strickyak/cocoio-bufferio-kicad/cocoio-bufferio-4/cocoio-bufferio-4.png

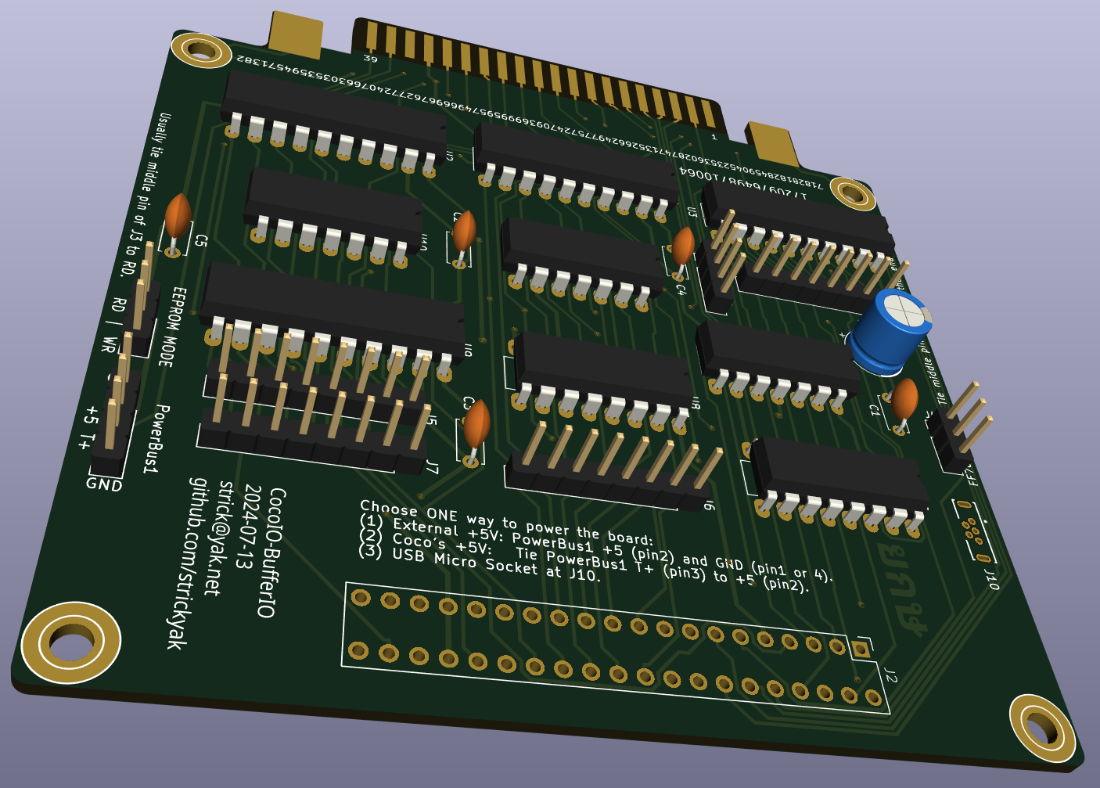
cocoio-bufferio-4/cocoio-bufferio-4.png
