strickyak/cocoio-bufferio-kicad/README.md

# cocoio-bufferio-kicad
for diagnostic use
