strickyak/cocoio-bufferio-kicad/cocoio-bufferio-4/cocoio-bufferio-4.kicad_pcb

## KiCad design cocoio-bufferio-4/cocoio-bufferio-4.kicad_pcb (2024-07-16)

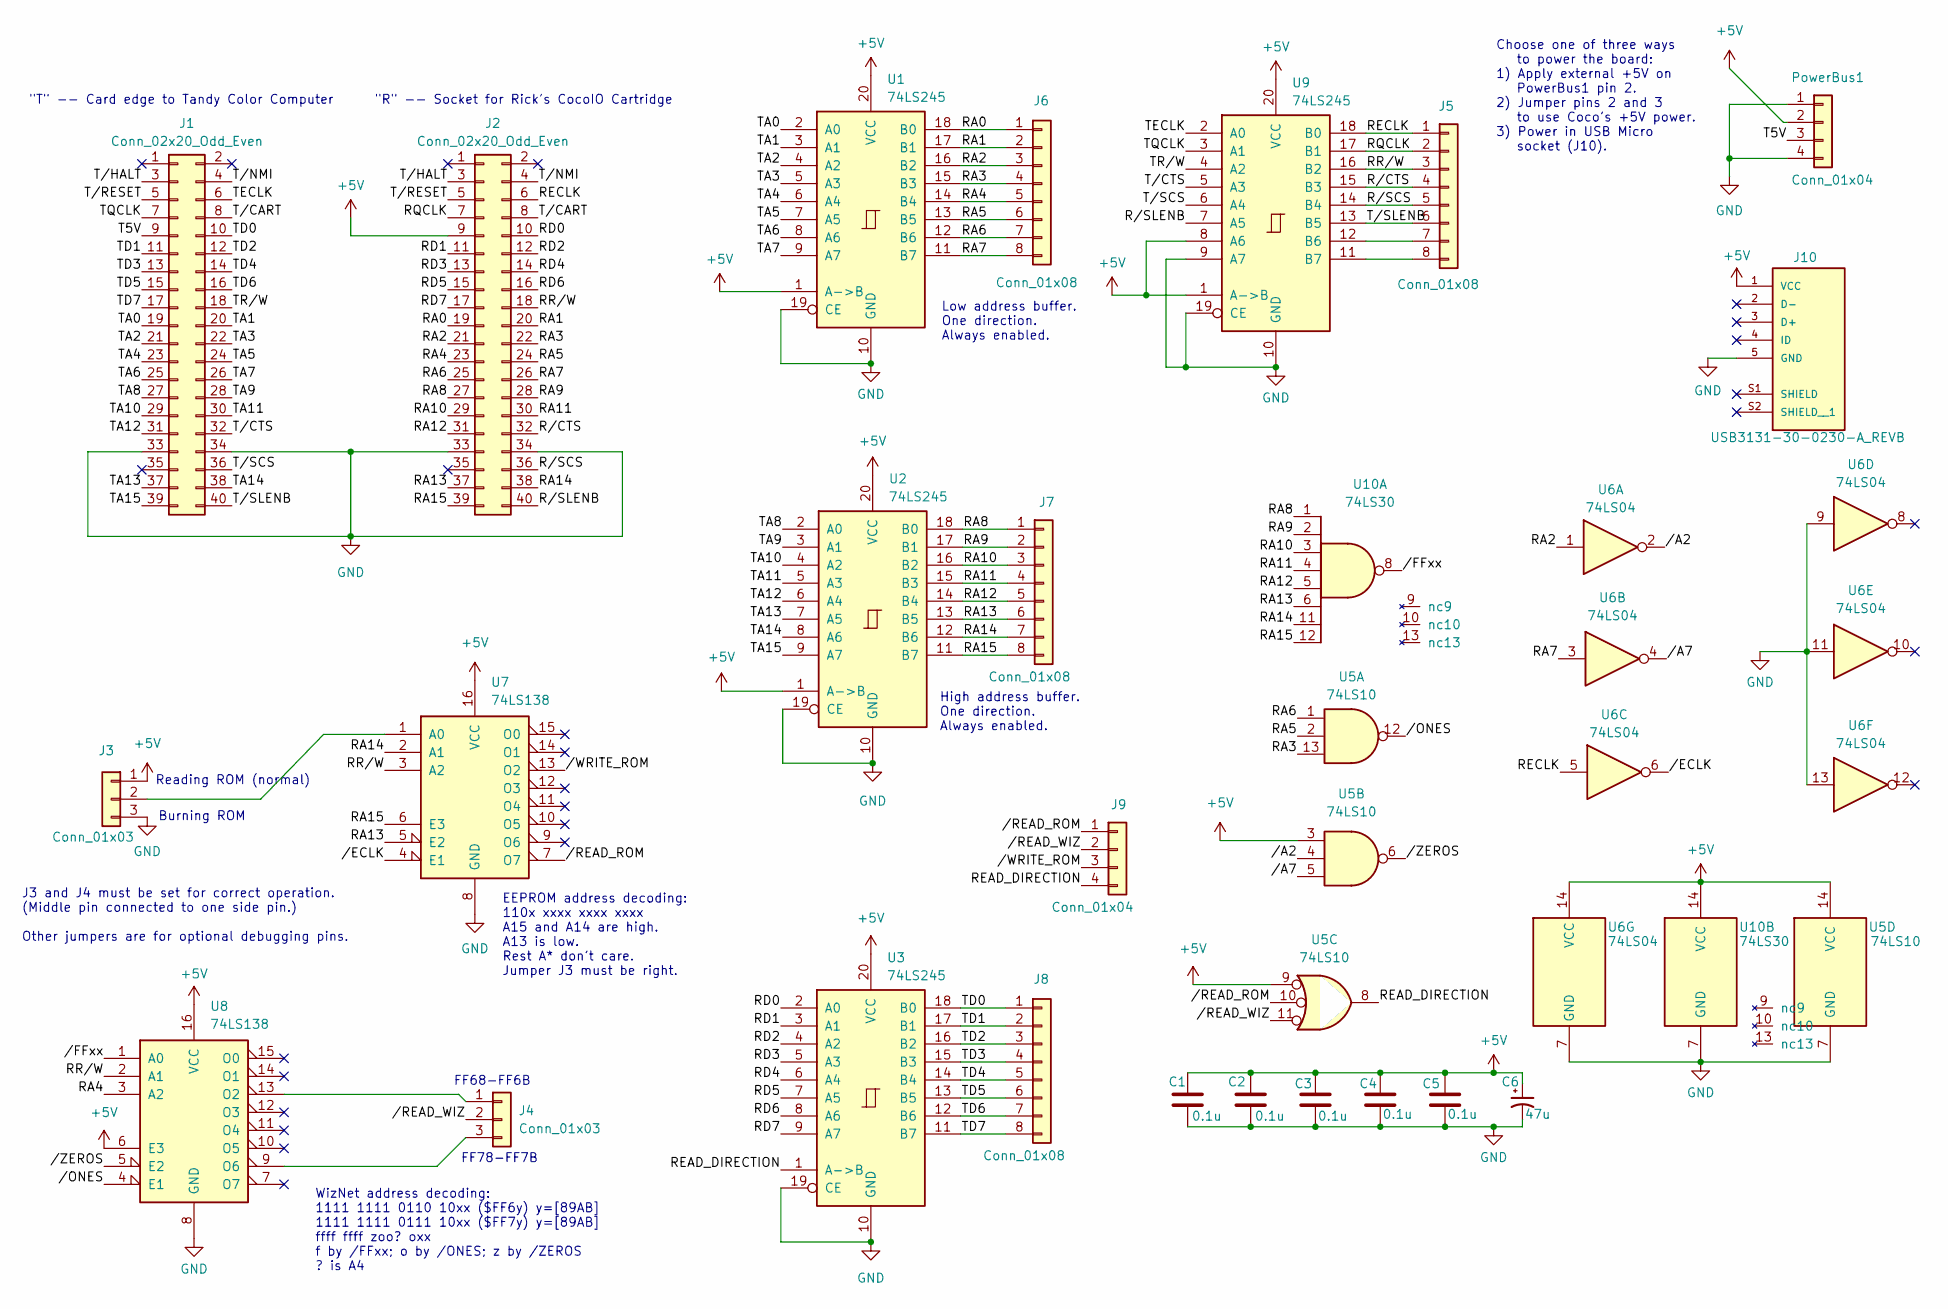
[picture p2: schematic cocoio-bufferio-4.kicad_sch, CocoIO-BufferIO]

Parts:
C1, C2, C3, C4, C5: 0.1u; C_Disc_D5.0mm_W2.5mm_P5.00mm
C6: 47u; CP_Radial_D7.5mm_P2.50mm
J1: Conn_02x20_Odd_Even; CocoCardEdge
J2: Conn_02x20_Odd_Even; Coco_Card_Female
J3, J4: Conn_01x03; PinHeader_1x03_P2.54mm_Vertical
J5, J6, J7, J8: Conn_01x08; PinHeader_1x08_P2.54mm_Vertical
J9: Conn_01x04; PinHeader_1x04_P2.54mm_Vertical
J10: USB3131-30-0230-A_REVB; GCT_USB3131-30-0230-A_REVB; PARTREV B4
PowerBus1: Conn_01x04; PinHeader_1x04_P2.54mm_Vertical
U1, U2, U3, U9: 74LS245; DIP-20_W7.62mm_LongPads
U5: 74LS10; DIP-14_W7.62mm_LongPads
U6: 74LS04; DIP-14_W7.62mm_LongPads
U7, U8: 74LS138; DIP-16_W7.62mm_LongPads
U10: 74LS30; DIP-14_W7.62mm_LongPads

Connections:
+5V: C1.1, C2.1, C3.1, C4.1, C5.1, C6.1, J2.9, J3.1, J10.1 (VCC), PowerBus1.2, U1.1 (A->B), U1.20 (VCC), U2.1 (A->B), U2.20 (VCC), U3.20 (VCC), U5.3, U5.9, U5.14 (VCC), U6.14 (VCC), U7.16 (VCC), U8.6 (E3), U8.16 (VCC), U9.1 (A->B), U9.8 (A6), U9.20 (VCC), U10.14 (VCC)
/RA0: J2.19, J6.1, U1.18 (B0)
/RA1: J2.20, J6.2, U1.17 (B1)
/RA2: J2.21, J6.3, U1.16 (B2), U6.1
/RA3: J2.22, J6.4, U1.15 (B3), U5.13
/RA4: J2.23, J6.5, U1.14 (B4), U8.3 (A2)
/RA5: J2.24, J6.6, U1.13 (B5), U5.2
/RA6: J2.25, J6.7, U1.12 (B6), U5.1
/RA7: J2.26, J6.8, U1.11 (B7), U6.3
/RA8: J2.27, J7.1, U2.18 (B0), U10.1
/RA9: J2.28, J7.2, U2.17 (B1), U10.2
/RA10: J2.29, J7.3, U2.16 (B2), U10.3
/RA11: J2.30, J7.4, U2.15 (B3), U10.4
/RA12: J2.31, J7.5, U2.14 (B4), U10.5
/RA13: J2.37, J7.6, U2.13 (B5), U7.5 (E2), U10.6
/RA14: J2.38, J7.7, U2.12 (B6), U7.2 (A1), U10.11
/RA15: J2.39, J7.8, U2.11 (B7), U7.6 (E3), U10.12
/RD0: J2.10, U3.2 (A0)
/RD1: J2.11, U3.3 (A1)
/RD2: J2.12, U3.4 (A2)
/RD3: J2.13, U3.5 (A3)
/RD4: J2.14, U3.6 (A4)
/RD5: J2.15, U3.7 (A5)
/RD6: J2.16, U3.8 (A6)
/RD7: J2.17, U3.9 (A7)
/READ_DIRECTION: J9.4, U3.1 (A->B), U5.8
/RECLK: J2.6, J5.1, U6.5, U9.18 (B0)
/RQCLK: J2.7, J5.2, U9.17 (B1)
/RR/W: J2.18, J5.3, U7.3 (A2), U8.2 (A1), U9.16 (B2)
/R/CTS: J2.32, J5.4, U9.15 (B3)
/R/SCS: J2.36, J5.5, U9.14 (B4)
/R/SLENB: J2.40, U9.7 (A5)
/T5V: J1.9, PowerBus1.3
/TA0: J1.19, U1.2 (A0)
/TA1: J1.20, U1.3 (A1)
/TA2: J1.21, U1.4 (A2)
/TA3: J1.22, U1.5 (A3)
/TA4: J1.23, U1.6 (A4)
/TA5: J1.24, U1.7 (A5)
/TA6: J1.25, U1.8 (A6)
/TA7: J1.26, U1.9 (A7)
/TA8: J1.27, U2.2 (A0)
/TA9: J1.28, U2.3 (A1)
/TA10: J1.29, U2.4 (A2)
/TA11: J1.30, U2.5 (A3)
/TA12: J1.31, U2.6 (A4)
/TA13: J1.37, U2.7 (A5)
/TA14: J1.38, U2.8 (A6)
/TA15: J1.39, U2.9 (A7)
/TD0: J1.10, J8.1, U3.18 (B0)
/TD1: J1.11, J8.2, U3.17 (B1)
/TD2: J1.12, J8.3, U3.16 (B2)
/TD3: J1.13, J8.4, U3.15 (B3)
/TD4: J1.14, J8.5, U3.14 (B4)
/TD5: J1.15, J8.6, U3.13 (B5)
/TD6: J1.16, J8.7, U3.12 (B6)
/TD7: J1.17, J8.8, U3.11 (B7)
/TECLK: J1.6, U9.2 (A0)
/TQCLK: J1.7, U9.3 (A1)
/TR/W: J1.18, U9.4 (A2)
/T/CART: J1.8, J2.8
/T/CTS: J1.32, U9.5 (A3)
/T/HALT: J1.3, J2.3
/T/NMI: J1.4, J2.4
/T/RESET: J1.5, J2.5
/T/SCS: J1.36, U9.6 (A4)
/T/SLENB: J1.40, J5.6, U9.13 (B5)
//A2: U5.4, U6.2
//A7: U5.5, U6.4
//ECLK: U6.6, U7.4 (E1)
//FFxx: U8.1 (A0), U10.8
//ONES: U5.12, U8.4 (E1)
//READ_ROM: J9.1, U5.10, U7.7 (O7)
//READ_WIZ: J4.2, J9.2, U5.11
//WRITE_ROM: J9.3, U7.13 (O2)
//ZEROS: U5.6, U8.5 (E2)
GND: C1.2, C2.2, C3.2, C4.2, C5.2, C6.2, J1.33, J1.34, J2.33, J2.34, J3.3, J10.5 (GND), PowerBus1.1, PowerBus1.4, U1.10 (GND), U1.19 (CE), U2.10 (GND), U2.19 (CE), U3.10 (GND), U3.19 (CE), U5.7 (GND), U6.7 (GND), U6.9, U6.11, U6.13, U7.8 (GND), U8.8 (GND), U9.9 (A7), U9.10 (GND), U9.19 (CE), U10.7 (GND); also elsewhere on the board
unnamed: J3.2, U7.1 (A0)
unnamed: J4.1, U8.13 (O2)
unnamed: J4.3, U8.9 (O6)
unnamed: J5.7, U9.12 (B6)
unnamed: J5.8, U9.11 (B7)

Notes on the sheet:
Burning ROM
WizNet address decoding: 1111 1111 0110 10xx ($FF6y) y=[89AB] 1111 1111 0111 10xx ($FF7y) y=[89AB] ffff ffff zoo? oxx f by /FFxx; o by /ONES; z by /ZEROS ? is A4
J3 and J4 must be set for correct operation. (Middle pin connected to one side pin.) Other jumpers are for optional debugging pins.
FF68-FF6B
Choose one of three ways to power the board: 1) Apply external +5V on PowerBus1 pin 2. 2) Jumper pins 2 and 3 to use Coco's +5V power. 3) Power in USB Micro socket (J10).
"R" -- Socket for Rick's CocoIO Cartridge
EEPROM address decoding: 110x xxxx xxxx xxxx A15 and A14 are high. A13 is low. Rest A* don't care. Jumper J3 must be right.
Reading ROM (normal)
FF78-FF7B
Low address buffer. One direction. Always enabled.
"T" -- Card edge to Tandy Color Computer
High address buffer. One direction. Always enabled.

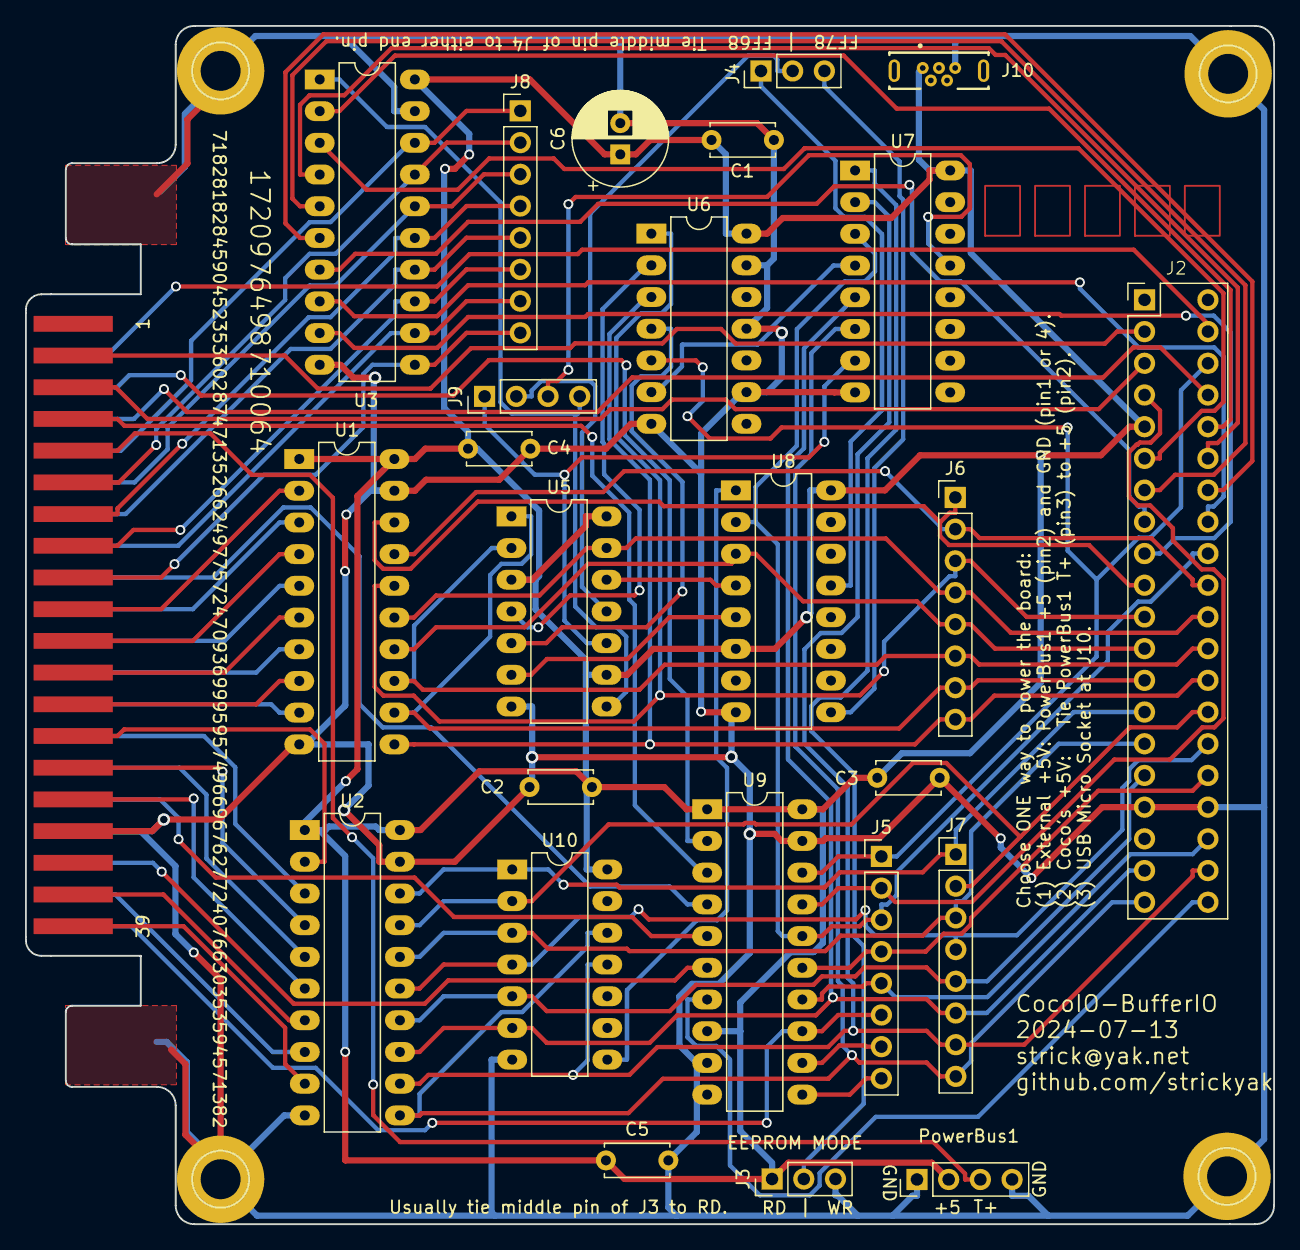
[picture p3: board cocoio-bufferio-4.kicad_pcb from above]

Board: 2 copper layers, 100.0 x 96.0 mm, 30 parts (0 on the bottom side), 82 nets.

Other parts of the board:
GND1, GND4, GND5x, GND5y: 1pin

Their connections:
GND: GND1.1, GND4.1, GND5x.1, GND5y.1; also elsewhere on the board
